KeKe115/Model-Railroad_Magazine/Markdown/img/IMG_5632.JPG

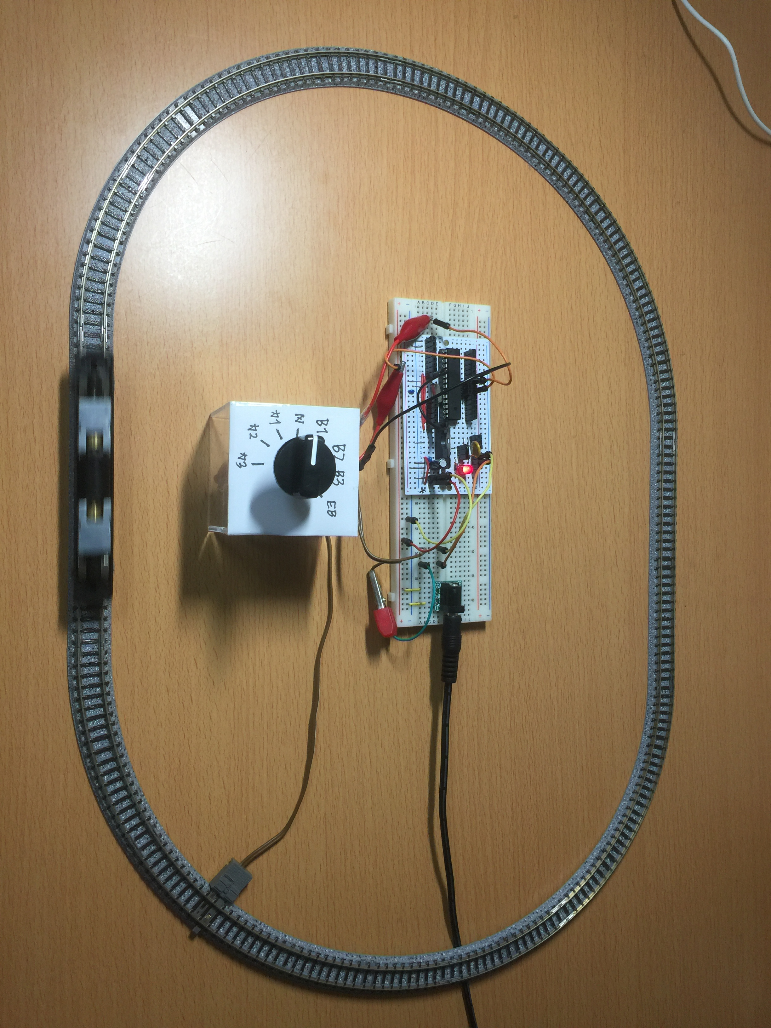
Markdown/img/IMG_5632.JPG
